DanielDW5555/mallard/README.md

# mallard
Ecological monitoring capstone for ECE 7000. The design will be a continuous redox measurement tool for peatlands.
