DanielDW5555/mallard/hardware/mallard.csv

Reference | Quantity | Value | Footprint | Datasheet | Digikey
BatteryPack1 | 1 | 3.7V | Battery:BatteryHolder_Keystone_1042_1x18650 | https://www.keyelco.com/userAssets/file/M65p27.pdf | 36-1042-ND
C1 C2 C3 C4 C5 C6 C7 C8 C9 C10 C12 C13 C14 C15 C21 | 15 | 1uF | Capacitor_SMD:C_0603_1608Metric_Pad1.08x0.95mm_HandSolder | http://weblib.samsungsem.com/mlcc/mlcc-ec-data-sheet.do?partNumber=CL10B105KO8NNN | 1276-1019-1-ND
C11 C23 | 2 | 10uF | Capacitor_SMD:C_0603_1608Metric_Pad1.08x0.95mm_HandSolder | https://www.yuden.co.jp/productdata/catalog/mlcc06_e.pdf | 587-3258-1-ND
C16 C17 C18 C19 C20 | 5 | 0.1uF | Capacitor_SMD:C_0603_1608Metric_Pad1.08x0.95mm_HandSolder |  | 445-8122-1-ND
C22 | 1 | 3.3uF | Capacitor_SMD:C_0603_1608Metric_Pad1.08x0.95mm_HandSolder | ~
D1 | 1 | D | Diode_SMD:D_SMA_Handsoldering | https://www.diodes.com/assets/Datasheets/ds16003.pdf | S1BFSCT-ND
D2 D3 D4 | 3 | LED | LED_SMD:LED_0603_1608Metric_Pad1.05x0.95mm_HandSolder | https://www.sunledusa.com/products/spec/XZVG53W-8.pdf | 1497-1215-1-ND
D5 | 1 | RED | LED_SMD:LED_0603_1608Metric_Pad1.05x0.95mm_HandSolder | ~
Eh1 Eh2 Eh3 | 3 | Eh Electrode | Connector_PinHeader_2.54mm:PinHeader_1x01_P2.54mm_Vertical | ~
J1 | 1 | USB_A | Connector_USB:USB3_A_Molex_48393-001 | https://media.digikey.com/pdf/Data%20Sheets/GCT%20PDFs/USB1130-USB1135.pdf | 2073-USB1135-15-9-L-B-ND
J2 | 1 | Conn_02x03_Odd_Even | Connector_PinHeader_1.27mm:PinHeader_2x03_P1.27mm_Vertical | https://s3.amazonaws.com/catalogspreads-pdf/PAGE94-95%20.050%20MALE%20HDR%20ST%20RA%20SMT.pdf | S9015E-03-ND
SM1 SM2 J3 SM3 | 4 | Conn_01x03 | Connector_PinHeader_2.54mm:PinHeader_1x03_P2.54mm_Vertical_SMD_Pin1Right | https://drawings-pdf.s3.amazonaws.com/11657.pdf | S1013EC-03-ND
J4 J5 J6 | 3 | Conn_01x03 | Connector_PinHeader_2.54mm:PinHeader_1x03_P2.54mm_Vertical | ~
L1 | 1 | 4.7uH | Inductor_SMD:L_0805_2012Metric_Pad1.05x1.20mm_HandSolder | ~ | 490-7782-1-ND
R1 R10x1 | 2 | 5.1k | Resistor_SMD:R_0603_1608Metric_Pad0.98x0.95mm_HandSolder | https://www.yageo.com/upload/media/product/productsearch/datasheet/rchip/PYu-RC_Group_51_RoHS_L_11.pdf | 311-5.10KHRCT-ND
R7 R11 R12 R22 | 4 | Jumper | Resistor_SMD:R_0603_1608Metric_Pad0.98x0.95mm_HandSolder | https://www.vishay.com/docs/20043/crcwhpe3.pdf | 541-0.0SBCT-ND
R14 | 1 | 1k | Resistor_SMD:R_0603_1608Metric_Pad0.98x0.95mm_HandSolder | https://www.vishay.com/docs/20065/rcse3.pdf | RHM1.00KADCT-ND
R15 | 1 | 30k | Resistor_SMD:R_0603_1608Metric_Pad0.98x0.95mm_HandSolder | https://www.yageo.com/upload/media/product/productsearch/datasheet/rchip/PYu-RT_1-to-0.01_RoHS_L_12.pdf | 311-30KDCT-ND
R16 | 1 | 20k DNI | Resistor_SMD:R_0603_1608Metric_Pad0.98x0.95mm_HandSolder | https://industrial.panasonic.com/cdbs/www-data/pdf/RDM0000/AOA0000C328.pdf | P20429CT-ND
R18 | 1 | 9.1k | Resistor_SMD:R_0603_1608Metric_Pad0.98x0.95mm_HandSolder | https://www.yageo.com/upload/media/product/productsearch/datasheet/rchip/PYu-RT_1-to-0.01_RoHS_L_12.pdf | YAG1756CT-ND
R10 R19 | 2 | 20k | Resistor_SMD:R_0603_1608Metric_Pad0.98x0.95mm_HandSolder | https://industrial.panasonic.com/cdbs/www-data/pdf/RDM0000/AOA0000C328.pdf | P20429CT-ND
R2 | 1 | 21.5k | Resistor_SMD:R_0603_1608Metric_Pad0.98x0.95mm_HandSolder | https://industrial.panasonic.com/cdbs/www-data/pdf/RDM0000/AOA0000C328.pdf | P20432CT-ND
R20 | 1 | 80.6k | Resistor_SMD:R_0603_1608Metric_Pad0.98x0.95mm_HandSolder | https://www.seielect.com/catalog/sei-rmcf_rmcp.pdf | RMCF0603FT80K6CT-ND
R21 | 1 | 324k | Resistor_SMD:R_0603_1608Metric_Pad0.98x0.95mm_HandSolder | https://industrial.panasonic.com/ww/products/pt/general-purpose-chip-resistors/models/ERJ3GEYJ362V | P3.6KGCT-ND
R23 | 1 | 680 | Resistor_SMD:R_0603_1608Metric_Pad0.98x0.95mm_HandSolder | https://www.yageo.com/upload/media/product/productsearch/datasheet/rchip/PYu-AC_51_RoHS_L_7.pdf | YAG3624CT-ND
R4 R6 R8 R13 R17 R24 | 6 | 10k | Resistor_SMD:R_0603_1608Metric_Pad0.98x0.95mm_HandSolder | https://www.yageo.com/upload/media/product/productsearch/datasheet/rchip/PYu-RC_Group_51_RoHS_L_11.pdf | 13-RC0603DR-0710KLCT-ND
R25 | 1 | 370 | Resistor_SMD:R_0603_1608Metric_Pad0.98x0.95mm_HandSolder | ~
R3 R5 | 2 | 3.6k | Resistor_SMD:R_0603_1608Metric_Pad0.98x0.95mm_HandSolder | https://industrial.panasonic.com/ww/products/pt/general-purpose-chip-resistors/models/ERJ3GEYJ362V | P3.6KGCT-ND
R9 | 1 | Jumper DNI | Resistor_SMD:R_0603_1608Metric_Pad0.98x0.95mm_HandSolder | https://www.vishay.com/docs/20043/crcwhpe3.pdf | 541-0.0SBCT-ND
Ref1 | 1 | Conn_01x02 | Connector_Coaxial:BNC_TEConnectivity_1478204_Vertical | https://www.te.com/commerce/DocumentDelivery/DDEController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 | A97581-ND
Ref2 | 1 | Conn_01x02 | mallard:mallardScrewTerm.
SW1 | 1 | RESET Switch | Button_Switch_SMD:SW_SPST_B3U-1000P | https://omronfs.omron.com/en_US/ecb/products/pdf/en-b3u.pdf | SW1020CT-ND
TH1 | 1 | 103AT | Resistor_THT:R_Axial_DIN0204_L3.6mm_D1.6mm_P2.54mm_Vertical | ~
U1 U2 U3 | 3 | TMP235 |  | https://www.ti.com/lit/ds/symlink/tmp235-q1.pdf?HQS=dis-dk-null-digikeymode-dsf-pf-null-wwe&ts=1643211475158 | 296-TMP235AEDBZTQ1CT-ND
U10 | 1 | LM828 | Package_TO_SOT_SMD:SOT-23-5 | https://www.ti.com/lit/ds/symlink/lm828.pdf?HQS=dis-dk-null-digikeymode-dsf-pf-null-wwe&ts=1643222784613 | 296-36289-1-ND
U11 | 1 | STM32L4Q5xx | Package_QFP:LQFP-48_7x7mm_P0.5mm | https://www.st.com/resource/en/datasheet/stm32l4q5ag.pdf | 497-STM32L4Q5CGT6-ND
U12 | 1 | LTC3529EDCB | mallard:DFN200X300X80-9N | https://www.analog.com/media/en/technical-documentation/data-sheets/3529fb.pdf | 161-LTC3529EDCB#TRPBFCT-ND
U4 | 1 | BQ24210DQCT | Package_SON:WSON-10-1EP_2x3mm_P0.5mm_EP0.84x2.4mm | https://www.ti.com/lit/ds/symlink/bq24210.pdf?HQS=dis-dk-null-digikeymode-dsf-pf-null-wwe&ts=1627409280722 | 296-28738-1-ND
U5 U6 | 2 | TMUX1309 | Package_DFN_QFN:WQFN-16-1EP_3x3mm_P0.5mm_EP1.6x1.6mm | https://www.ti.com/lit/ds/symlink/tmux1309.pdf | 296-TMUX1309BQBRCT-ND
U7 | 1 | LMP7721 | Package_SO:SOIC-8_3.9x4.9mm_P1.27mm | https://www.ti.com/general/docs/suppproductinfo.tsp?distId=10 | LMP7721MA/NOPB-ND
U8 | 1 | TPS71710DRVR | Package_SON:WSON-6-1EP_2x2mm_P0.65mm_EP1x1.6mm | https://www.ti.com/lit/ds/symlink/tps717.pdf?HQS=dis-dk-null-digikeymode-dsf-pf-null-wwe&ts=1633366861578 | 296-22984-1-ND
U9 | 1 | LMV554 | Package_SO:TSSOP-14_4.4x5mm_P0.65mm | https://www.ti.com/lit/ds/symlink/lmv551.pdf?HQS=dis-dk-null-digikeymode-dsf-pf-null-wwe&ts=1626469395066 | 296-51370-1-ND
