DanielDW5555/mallard/hardware/mallard.kicad_pcb

## KiCad design hardware/mallard.kicad_pcb (2022-01-26)

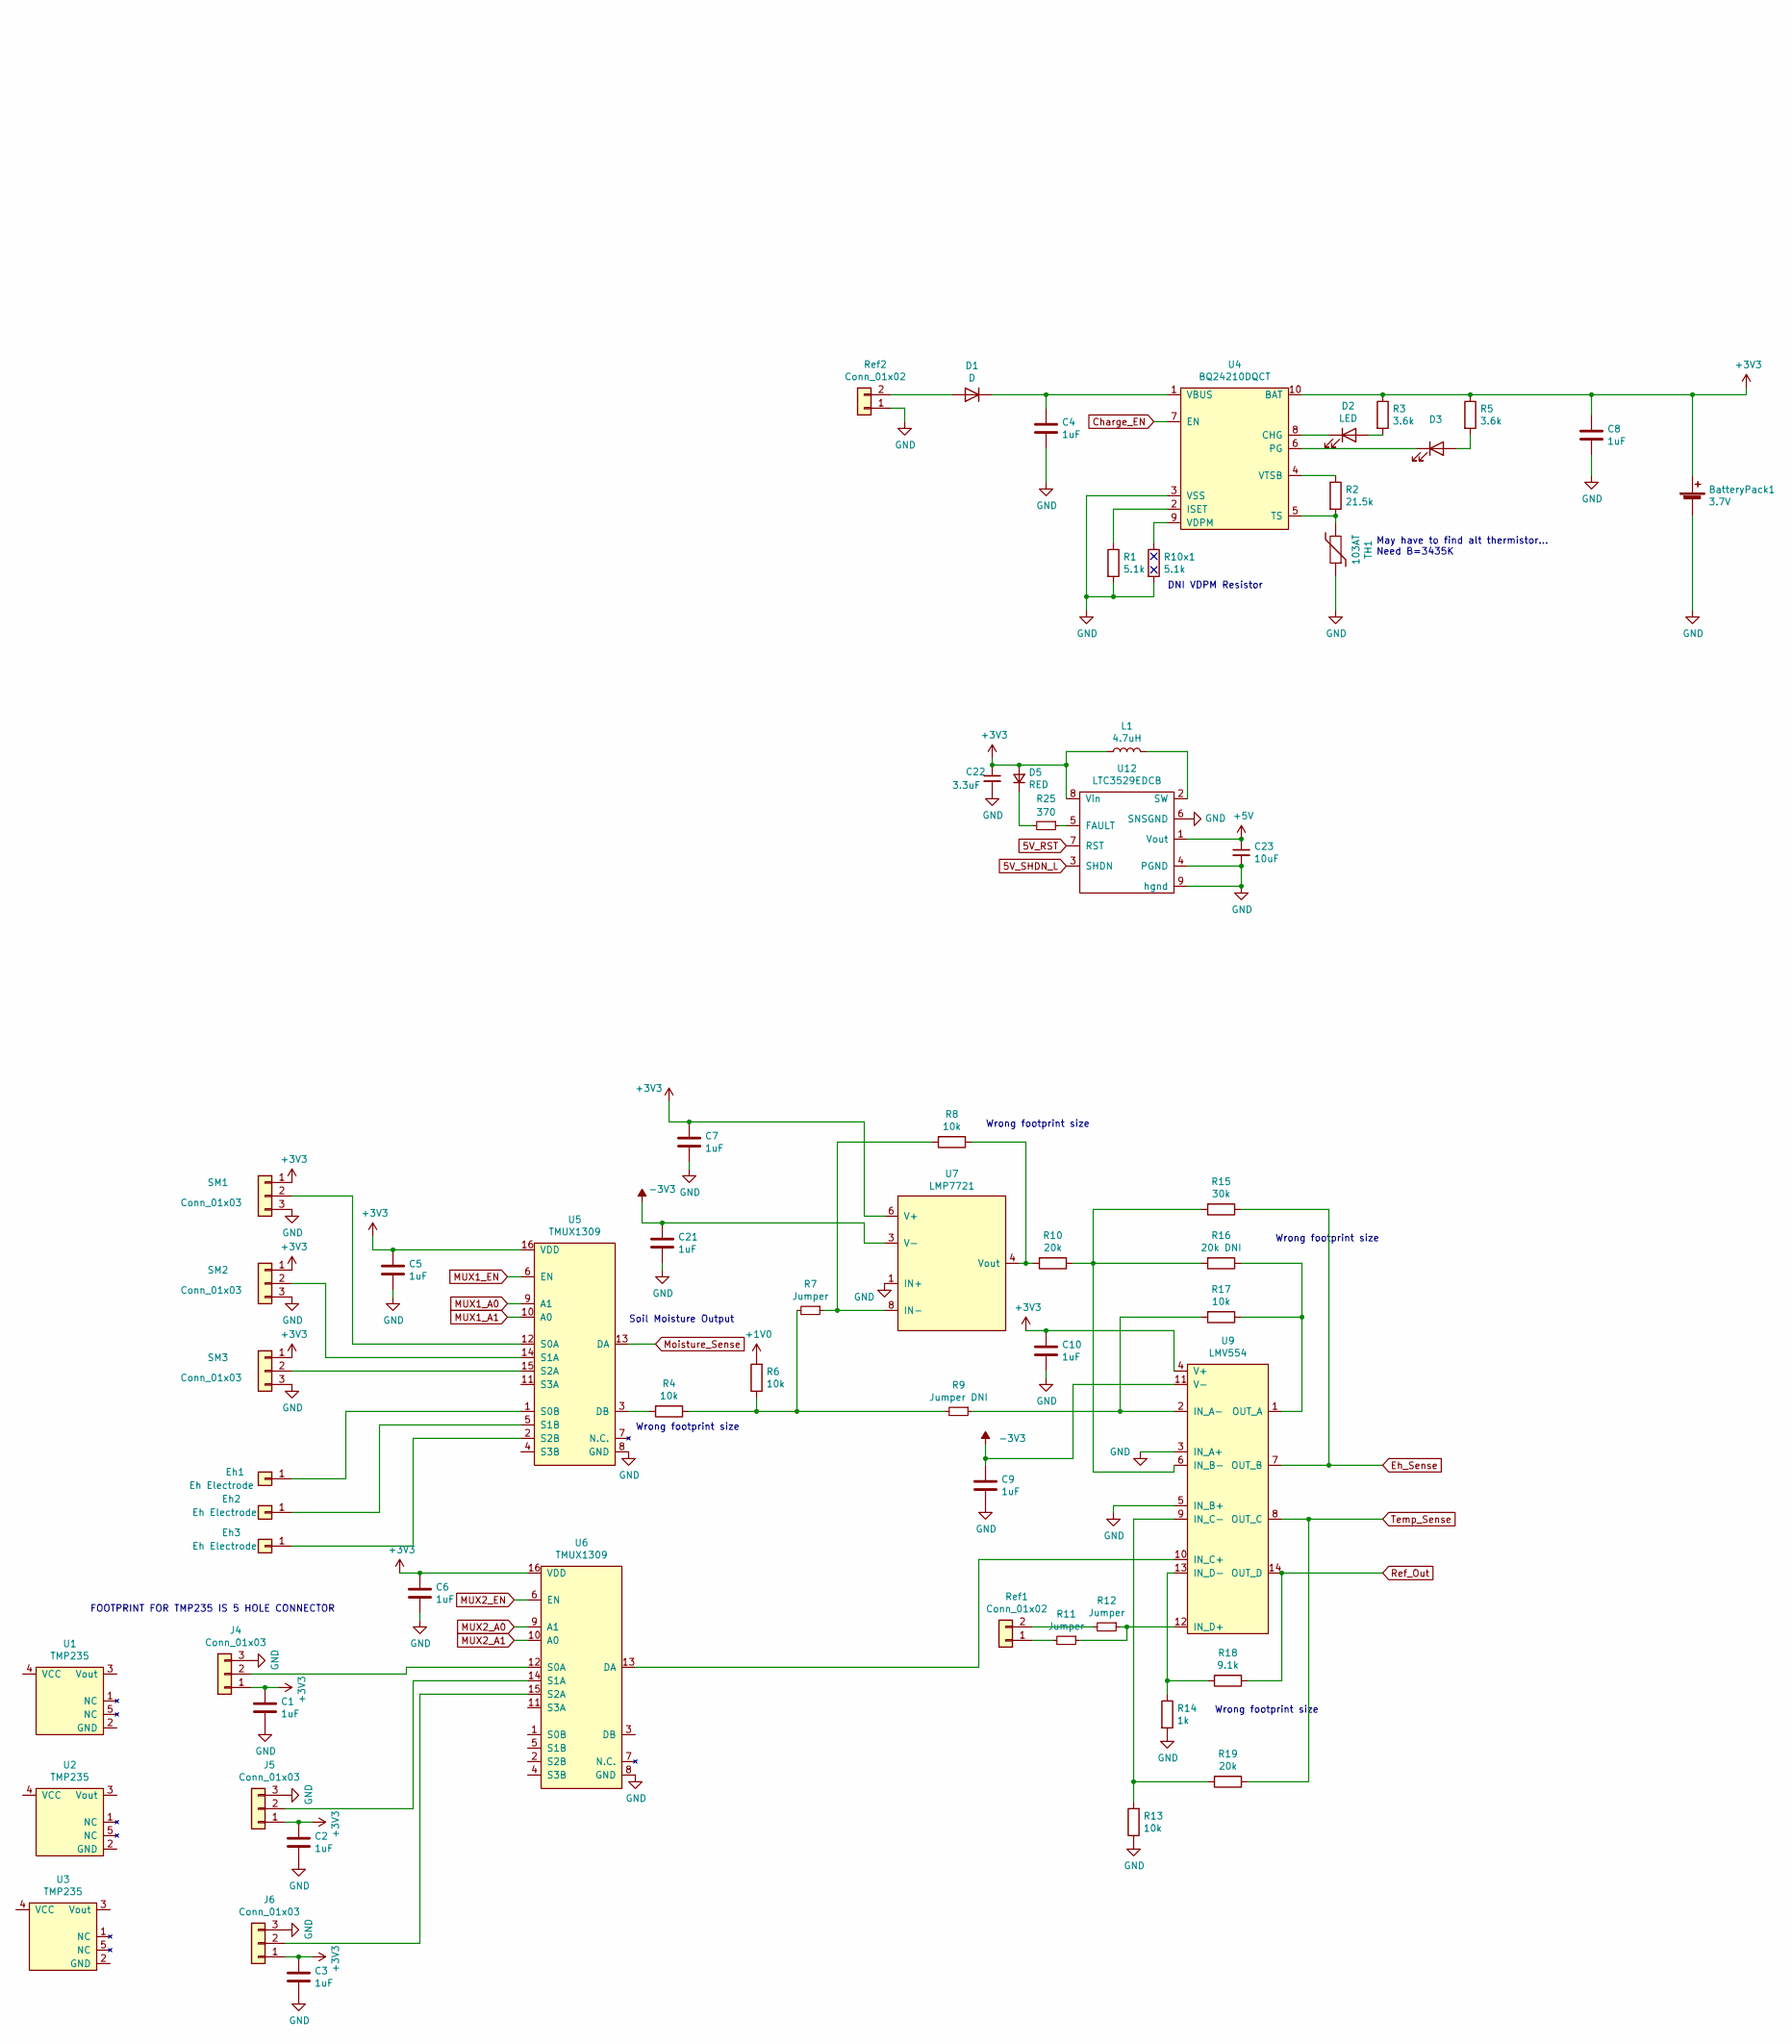
[picture p1: schematic mallard.sch, part in row 1, column 1]

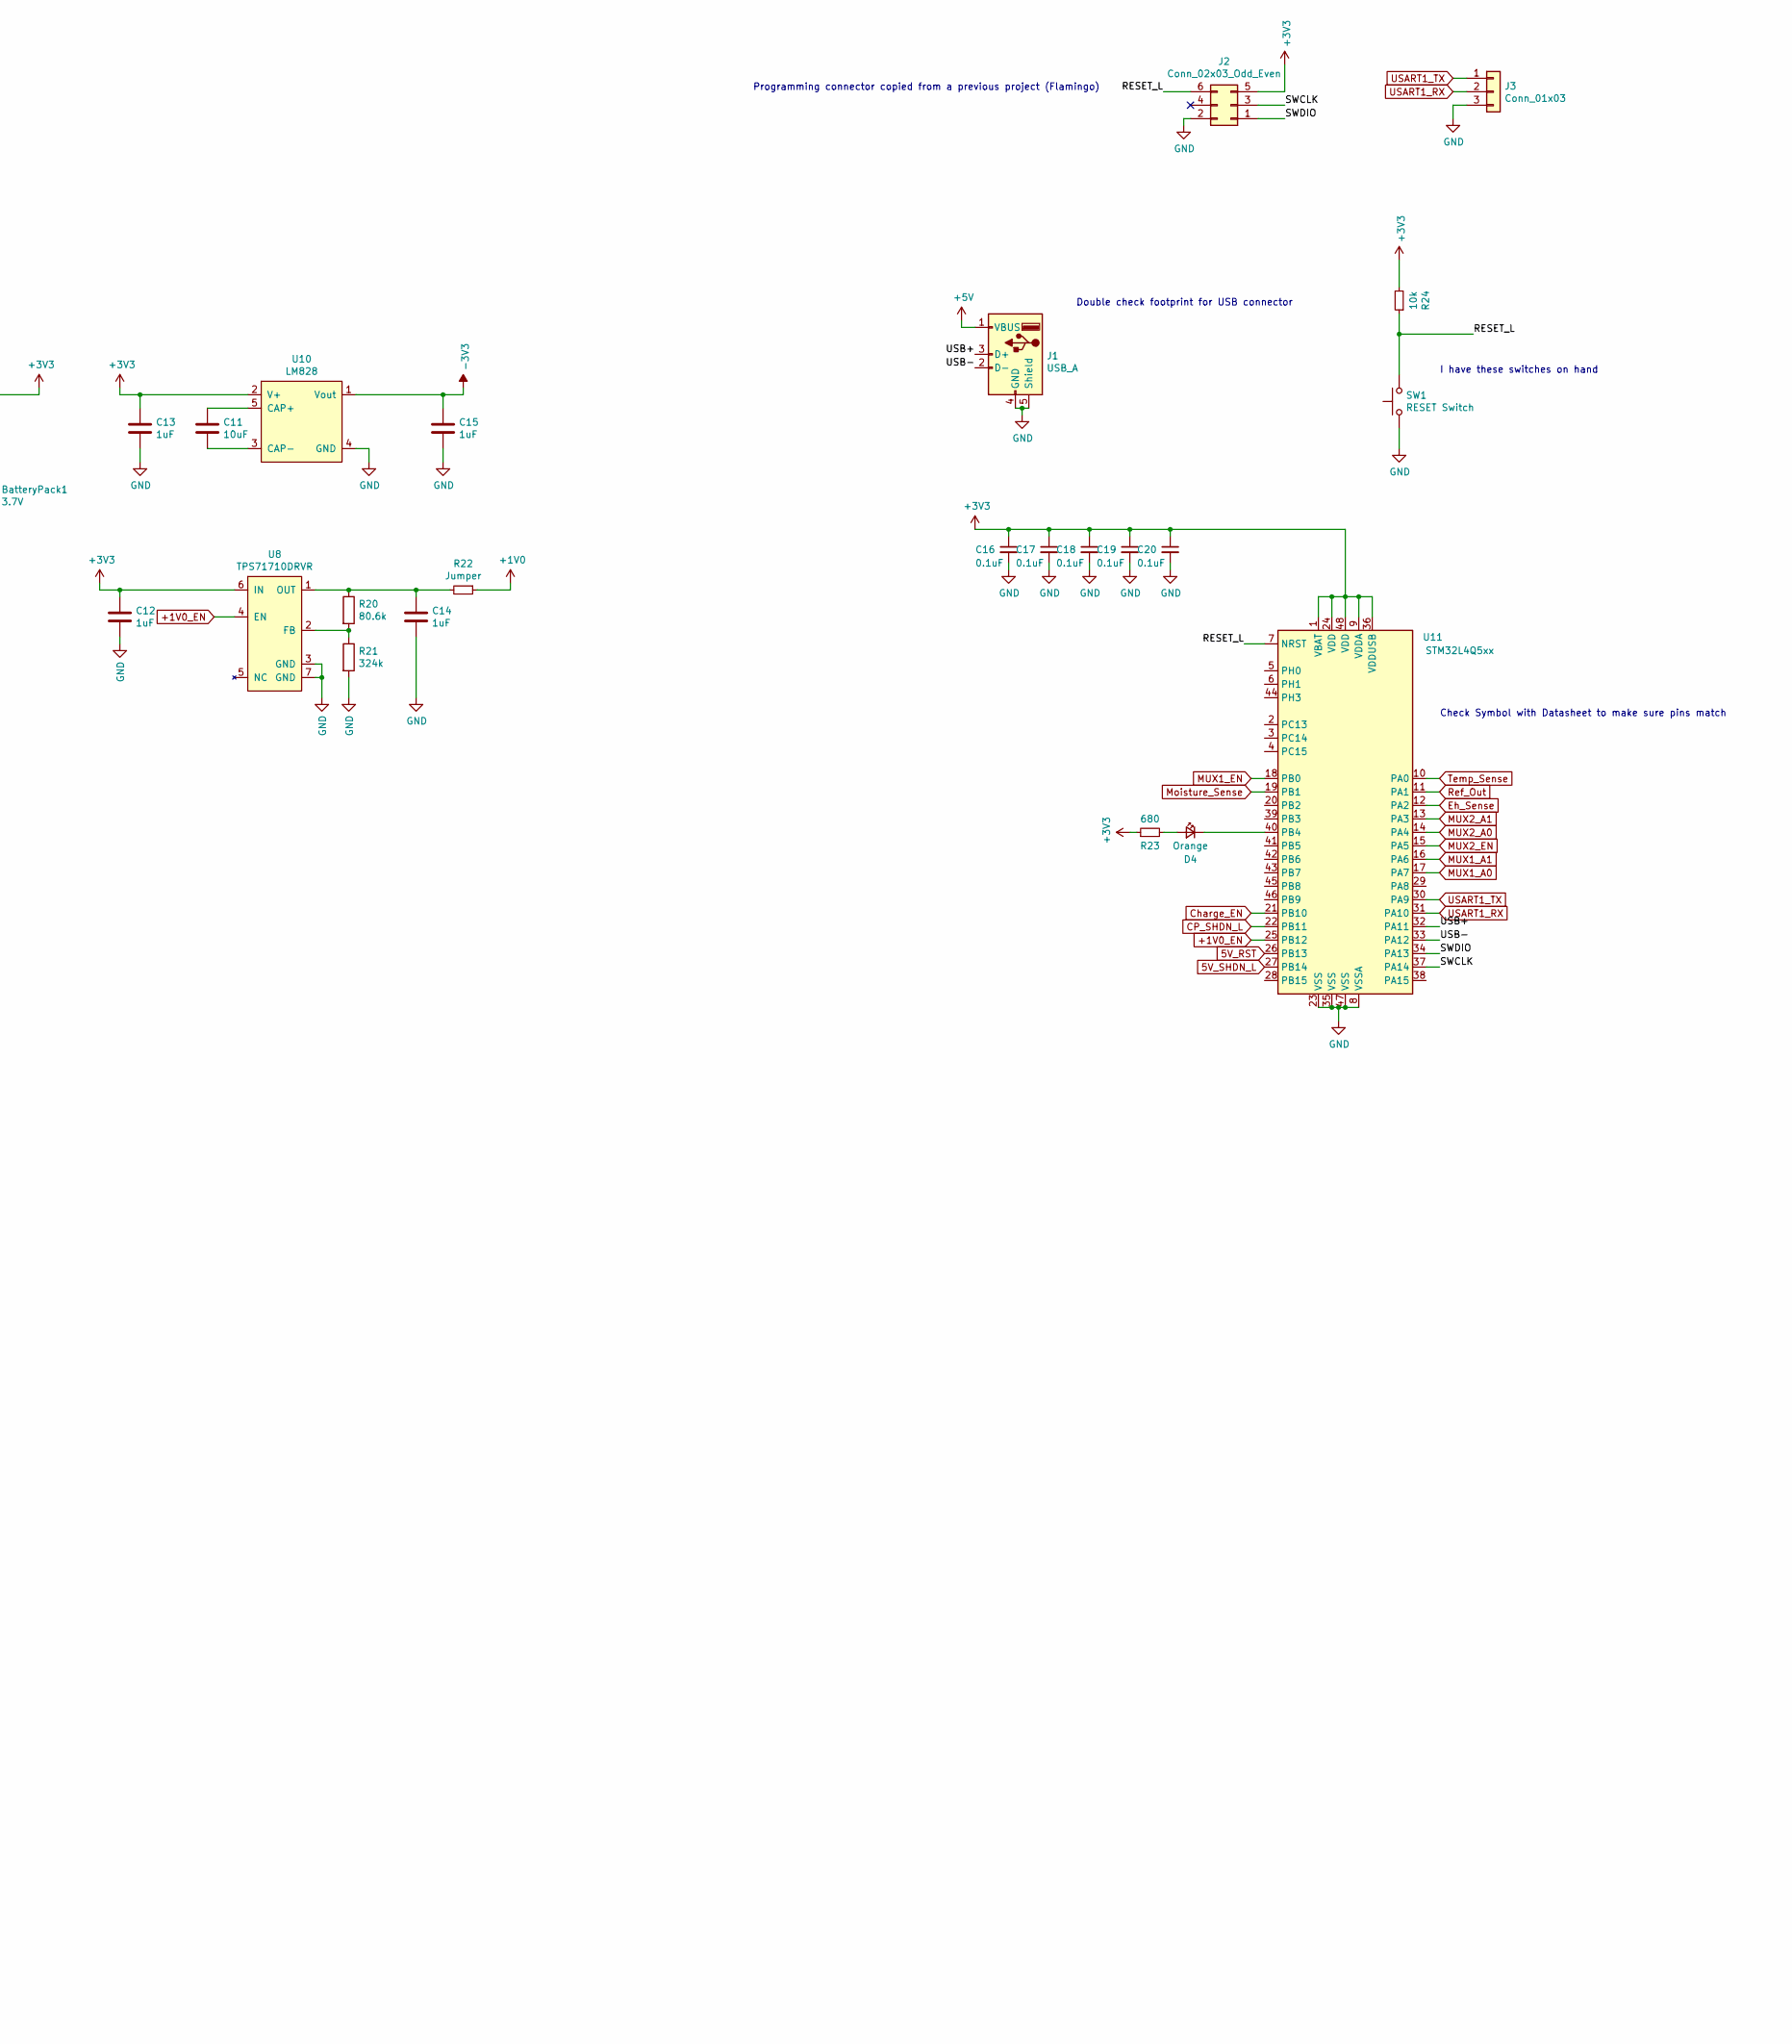
[picture p2: schematic mallard.sch, part in row 1, column 2]

Parts:
BatteryPack1: 3.7V; BatteryHolder_Keystone_1042_1x18650; Digikey 36-1042-ND
C1, C2, C3, C4, C5, C6, C7, C8, C9, C10, C12, C13, C14, C15, C21: 1uF; C_0603_1608Metric_Pad1.08x0.95mm_HandSolder; Digikey 311-1446-1-ND
C11: 10uF; C_0603_1608Metric_Pad1.08x0.95mm_HandSolder; Digikey 587-3258-1-ND
C16, C17, C18, C19, C20: 0.1uF; C_0603_1608Metric_Pad1.08x0.95mm_HandSolder; Digikey 445-8122-1-ND
C22: 3.3uF; C_0603_1608Metric_Pad1.08x0.95mm_HandSolder
C23: 10uF; C_0603_1608Metric_Pad1.08x0.95mm_HandSolder
D1: D; D_SMA_Handsoldering; Digikey S1B-FDICT-ND
D2, D3: LED; LED_0603_1608Metric_Pad1.05x0.95mm_HandSolder; Digikey 1497-1215-1-ND
D4: Orange; D_0805_2012Metric_Castellated; Digikey 160-1413-1-ND
D5: RED; LED_0603_1608Metric_Pad1.05x0.95mm_HandSolder
Eh1, Eh2, Eh3: Eh Electrode; PinHeader_1x01_P2.54mm_Vertical
J1: USB_A; USB3_A_Molex_48393-001; Digikey 2073-USB1135-15-9-L-B-ND
J2: Conn_02x03_Odd_Even; PinHeader_2x03_P1.27mm_Vertical; Digikey S9015E-03-ND
J3: Conn_01x03; PinHeader_1x03_P2.54mm_Vertical_SMD_Pin1Right; Digikey S1013EC-03-ND
J4, J5, J6: Conn_01x03; PinHeader_1x03_P2.54mm_Vertical
L1: 4.7uH; L_0805_2012Metric_Pad1.05x1.20mm_HandSolder; Digikey 490-7782-1-ND
R1, R10x1: 5.1k; R_0603_1608Metric_Pad0.98x0.95mm_HandSolder; Digikey 311-5.10KHRCT-ND
R2: 21.5k; R_0603_1608Metric_Pad0.98x0.95mm_HandSolder; Digikey P20432CT-ND
R3, R5: 3.6k; R_0603_1608Metric_Pad0.98x0.95mm_HandSolder; Digikey P3.6KGCT-ND
R4, R6, R8, R13, R17, R24: 10k; R_0603_1608Metric_Pad0.98x0.95mm_HandSolder; Digikey 13-RC0603DR-0710KLCT-ND
R7, R11, R12, R22: Jumper; R_0603_1608Metric_Pad0.98x0.95mm_HandSolder; Digikey 541-0.0SBCT-ND
R9: Jumper DNI; R_0603_1608Metric_Pad0.98x0.95mm_HandSolder; Digikey 541-0.0SBCT-ND
R10, R19: 20k; R_0603_1608Metric_Pad0.98x0.95mm_HandSolder; Digikey P20429CT-ND
R14: 1k; R_0603_1608Metric_Pad0.98x0.95mm_HandSolder; Digikey 541-2788-1-ND
R15: 30k; R_0603_1608Metric_Pad0.98x0.95mm_HandSolder; Digikey 311-30KDCT-ND
R16: 20k DNI; R_0603_1608Metric_Pad0.98x0.95mm_HandSolder; Digikey P20429CT-ND
R18: 9.1k; R_0603_1608Metric_Pad0.98x0.95mm_HandSolder; Digikey YAG1756CT-ND
R20: 80.6k; R_0603_1608Metric_Pad0.98x0.95mm_HandSolder; Digikey RMCF0603FT80K6CT-ND
R21: 324k; R_0603_1608Metric_Pad0.98x0.95mm_HandSolder; Digikey P3.6KGCT-ND
R23: 680; R_0603_1608Metric_Pad0.98x0.95mm_HandSolder; Digikey YAG3624CT-ND
R25: 370; R_0603_1608Metric_Pad0.98x0.95mm_HandSolder
Ref1: Conn_01x02; BNC_TEConnectivity_1478204_Vertical; Digikey A97581-ND
Ref2: Conn_01x02; mallardScrewTerm.
SM1, SM2, SM3: Conn_01x03; PinHeader_1x03_P2.54mm_Vertical_SMD_Pin1Right; Digikey S1013EC-03-ND
SW1: RESET Switch; SW_SPST_B3U-1000P; Digikey SW1020CT-ND
TH1: 103AT; R_Axial_DIN0204_L3.6mm_D1.6mm_P2.54mm_Vertical
U1, U2, U3: TMP235; Digikey 296-48860-1-ND
U4: BQ24210DQCT; WSON-10-1EP_2x3mm_P0.5mm_EP0.84x2.4mm; Digikey 296-28738-1-ND
U5, U6: TMUX1309; WQFN-16-1EP_3x3mm_P0.5mm_EP1.6x1.6mm; Digikey 296-TMUX1309BQBRCT-ND
U7: LMP7721; SOIC-8_3.9x4.9mm_P1.27mm; Digikey LMP7721MA/NOPB-ND
U8: TPS71710DRVR; WSON-6-1EP_2x2mm_P0.65mm_EP1x1.6mm; Digikey 296-22984-1-ND
U9: LMV554; TSSOP-14_4.4x5mm_P0.65mm; Digikey 296-51370-1-ND
U10: LM828; SOT-23-5; Digikey 296-36289-1-ND
U11: STM32L4Q5xx; LQFP-48_7x7mm_P0.5mm; Digikey 497-STM32L4Q5CGT6-ND
U12: LTC3529EDCB; DFN200X300X80-9N; Digikey 161-LTC3529EDCB#TRPBFCT-ND

Connections:
5V_RST: U11.26 (PB13), U12.7 (RST)
5V_SHDN_L: U11.27 (PB14), U12.3 (SHDN)
+1V0: R6.2, R22.1
+1V0_EN: U8.4 (EN), U11.25 (PB12)
+3V3: BatteryPack1.1 (+), C1.1, C2.1, C3.1, C5.1, C6.1, C7.1, C8.1, C10.1, C12.1, C13.1, C16.1, C17.1, C18.1, C19.1, C20.1, C22.1, D5.2 (A), J2.5, J4.1, J5.1, J6.1, L1.1, R3.1, R5.1, R23.1, R24.2, SM1.1, SM2.1, SM3.1, U4.10 (BAT), U5.16 (VDD), U6.16 (VDD), U7.6 (V+), U8.6 (IN), U9.4 (V+), U10.2 (V+), U11.1 (VBAT), U11.9 (VDDA), U11.24 (VDD), U11.36 (VDDUSB), U11.48 (VDD), U12.8 (Vin)
+5V: C23.1, J1.1 (VBUS), U12.1 (Vout)
-3V3: C9.1, C15.1, C21.1, U7.3 (V-), U9.11 (V-), U10.1 (Vout)
/RESET_L: J2.6, R24.1, SW1.2, U11.7 (NRST)
/SWCLK: J2.3, U11.37 (PA14)
/SWDIO: J2.1, U11.34 (PA13)
/USB+: J1.3 (D+), U11.32 (PA11)
/USB-: J1.2 (D-), U11.33 (PA12)
CP_SHDN_L: U11.22 (PB11)
Charge_EN: U4.7 (EN), U11.21 (PB10)
Eh_Sense: R15.1, U9.7 (OUT_B), U11.12 (PA2)
GND: BatteryPack1.2 (-), C1.2, C2.2, C3.2, C4.2, C5.2, C6.2, C7.2, C8.2, C9.2, C10.2, C12.2, C13.2, C14.2, C15.2, C16.2, C17.2, C18.2, C19.2, C20.2, C21.2, C22.2, C23.2, J1.4 (GND), J1.5 (Shield), J2.2, J3.3, J4.3, J5.3, J6.3, R1.2, R10x1.2, R13.1, R14.2, R21.2, Ref2.1, SM1.3, SM2.3, SM3.3, SW1.1, TH1.1, U4.3 (VSS), U5.8 (GND), U6.8 (GND), U7.1 (IN+), U8.3 (GND), U8.7 (GND), U9.3 (IN_A+), U9.5 (IN_B+), U10.4 (GND), U11.8 (VSSA), U11.23 (VSS), U11.35 (VSS), U11.47 (VSS), U12.4 (PGND), U12.6 (SNSGND), U12.9 (hgnd)
MUX1_A0: U5.9 (A1), U11.17 (PA7)
MUX1_A1: U5.10 (A0), U11.16 (PA6)
MUX1_EN: U5.6 (EN), U11.18 (PB0)
MUX2_A0: U6.9 (A1), U11.14 (PA4)
MUX2_A1: U6.10 (A0), U11.13 (PA3)
MUX2_EN: U6.6 (EN), U11.15 (PA5)
Moisture_Sense: U5.13 (DA), U11.19 (PB1)
unnamed: C4.1, D1.1 (K), U4.1 (VBUS)
unnamed: C11.1, U10.5 (CAP+)
unnamed: C11.2, U10.3 (CAP-)
unnamed: C14.1, R20.1, R22.2, U8.1 (OUT)
unnamed: D1.2 (A), Ref2.2
unnamed: D2.1 (K), U4.8 (CHG)
unnamed: D2.2 (A), R3.2
unnamed: D3.1 (K), U4.6 (PG)
unnamed: D3.2 (A), R5.2
unnamed: D4.1 (K), U11.40 (PB4)
unnamed: D4.2 (A), R23.2
unnamed: D5.1 (K), R25.2
unnamed: Eh1.1, U5.1 (S0B)
unnamed: Eh2.1, U5.5 (S1B)
unnamed: Eh3.1, U5.2 (S2B)
unnamed: J4.2, U6.12 (S0A)
unnamed: J5.2, U6.14 (S1A)
unnamed: J6.2, U6.15 (S2A)
unnamed: L1.2, U12.2 (SW)
unnamed: R1.1, U4.2 (ISET)
unnamed: R2.1, U4.4 (VTSB)
unnamed: R2.2, TH1.2, U4.5 (TS)
unnamed: R4.1, R6.1, R7.2, R9.2
unnamed: R4.2, U5.3 (DB)
unnamed: R7.1, R8.2, U7.8 (IN-)
unnamed: R10.1, R15.2, R16.2, U9.6 (IN_B-)
unnamed: R8.1, R10.2, U7.4 (Vout)
unnamed: R10x1.1, U4.9 (VDPM)
unnamed: R11.1, R12.1, U9.12 (IN_D+)
unnamed: R11.2, Ref1.1
unnamed: R12.2, Ref1.2
unnamed: R13.2, R19.2, U9.9 (IN_C-)
unnamed: R14.1, R18.2, U9.13 (IN_D-)
unnamed: R16.1, R17.1, U9.1 (OUT_A)
unnamed: R9.1, R17.2, U9.2 (IN_A-)
unnamed: R20.2, R21.1, U8.2 (FB)
unnamed: R25.1, U12.5 (FAULT)
unnamed: SM1.2, U5.12 (S0A)
unnamed: SM2.2, U5.14 (S1A)
unnamed: SM3.2, U5.15 (S2A)
unnamed: U6.13 (DA), U9.10 (IN_C+)
Ref_Out: R18.1, U9.14 (OUT_D), U11.11 (PA1)
Temp_Sense: R19.1, U9.8 (OUT_C), U11.10 (PA0)
USART1_RX: J3.2, U11.31 (PA10)
USART1_TX: J3.1, U11.30 (PA9)

Notes on the sheet:
Check Symbol with Datasheet to make sure pins match
Double check footprint for USB connector
I have these switches on hand
FOOTPRINT FOR TMP235 IS 5 HOLE CONNECTOR
DNI VDPM Resistor
May have to find alt thermistor... Need B=3435K
Programming connector copied from a previous project (Flamingo)
Wrong footprint size
Soil Moisture Output

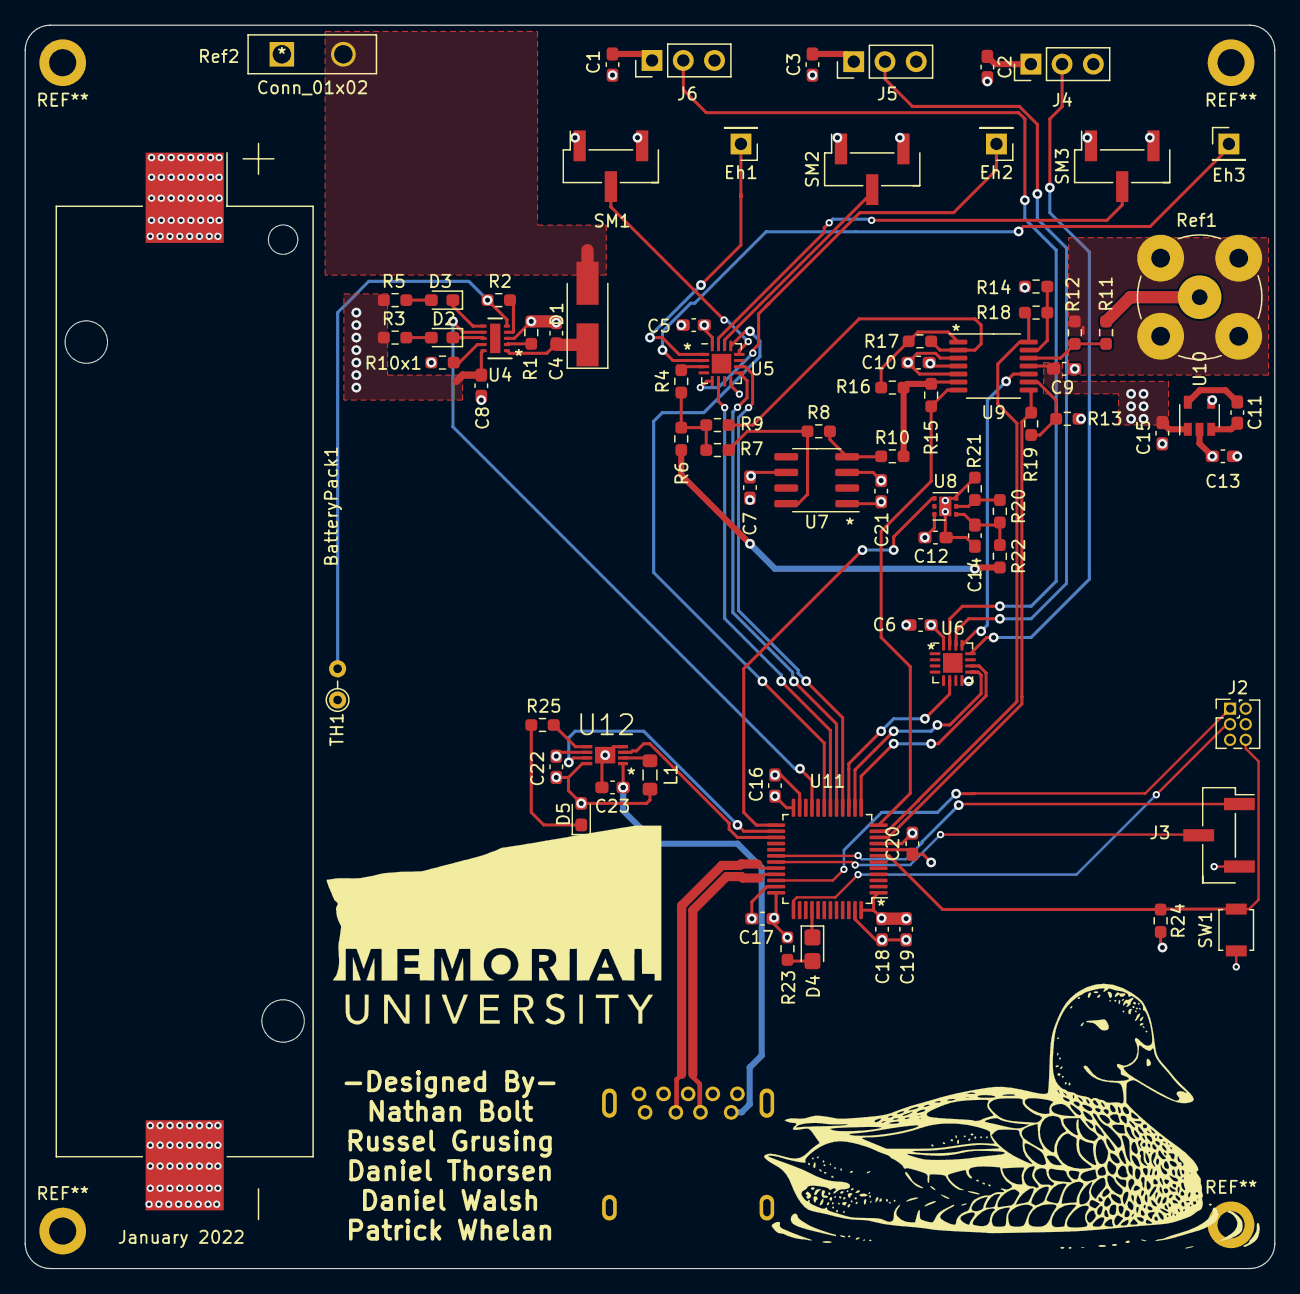
[picture p3: board mallard.kicad_pcb from above]

Board: 4 copper layers, 101.6 x 101.1 mm, 81 parts (1 on the bottom side), 67 nets.
