DanielDW5555/mallard/firmware/mallard/Core/Src/main.c

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
/* Includes ------------------------------------------------------------------*/
#include "main.h"
#include "fatfs.h"
#include "usb_host.h"

/* USER CODE BEGIN Includes */
#include <stdio.h>
/* USER CODE END Includes */

ADC_HandleTypeDef hadc1;

UART_HandleTypeDef huart1;

void SystemClock_Config(void);
void PeriphCommonClock_Config(void);
static void MX_GPIO_Init(void);
static void MX_ADC1_Init(void);
static void MX_USART1_UART_Init(void);
void MX_USB_HOST_Process(void);

/* USER CODE BEGIN 0 */
// ************************************************* START FUNCTIONS HERE ***************************************

// Blinky!!
void blinky(void)
{
	for(int i = 0; i < 2; i ++)
	{
		HAL_GPIO_TogglePin(GPIOB, GPIO_PIN_4);
		HAL_Delay(500);
		HAL_GPIO_TogglePin(GPIOB, GPIO_PIN_4);
		HAL_Delay(500);
	}
}

// ADC Channel Select EH
void ADC_Select_EH(void)
{
	ADC_ChannelConfTypeDef sConfig = {0};

	sConfig.Channel = ADC_CHANNEL_7;
	sConfig.Rank = 1;
	sConfig.SamplingTime = ADC_SAMPLETIME_2CYCLES_5;
	sConfig.SingleDiff = ADC_SINGLE_ENDED;
	sConfig.OffsetNumber = ADC_OFFSET_NONE;
	sConfig.Offset = 0;
	if (HAL_ADC_ConfigChannel(&hadc1, &sConfig) != HAL_OK)
	{
	Error_Handler();
	}
}

// ADC Channel Select REF
void ADC_Select_REF(void)
{
	ADC_ChannelConfTypeDef sConfig = {0};

	sConfig.Channel = ADC_CHANNEL_6;
	sConfig.Rank = 1;
	sConfig.SamplingTime = ADC_SAMPLETIME_2CYCLES_5;
	sConfig.SingleDiff = ADC_SINGLE_ENDED;
	sConfig.OffsetNumber = ADC_OFFSET_NONE;
	sConfig.Offset = 0;
	if (HAL_ADC_ConfigChannel(&hadc1, &sConfig) != HAL_OK)
	{
	Error_Handler();
	}
}

// ADC Channel Select TEMP
void ADC_Select_TEMP(void)
{
	ADC_ChannelConfTypeDef sConfig = {0};

	sConfig.Channel = ADC_CHANNEL_5;
	sConfig.Rank = 1;
	sConfig.SamplingTime = ADC_SAMPLETIME_2CYCLES_5;
	sConfig.SingleDiff = ADC_SINGLE_ENDED;
	sConfig.OffsetNumber = ADC_OFFSET_NONE;
	sConfig.Offset = 0;
	if (HAL_ADC_ConfigChannel(&hadc1, &sConfig) != HAL_OK)
	{
	Error_Handler();
	}
}

// UART Write
void _write(int file, char *ptr, int len)
{
	HAL_UART_Transmit(&huart1, (uint8_t*)ptr, len, HAL_MAX_DELAY);
}

/* USER CODE END 0 */

/**
  * @brief  The application entry point.
  * @retval int
  */
int main(void)
{
  /* MCU Configuration--------------------------------------------------------*/

  /* Reset of all peripherals, Initializes the Flash interface and the Systick. */
  HAL_Init();

  /* Configure the system clock */
  SystemClock_Config();

/* Configure the peripherals common clocks */
  PeriphCommonClock_Config();

  /* Initialize all configured peripherals */
  MX_GPIO_Init();
  MX_ADC1_Init();
  MX_USART1_UART_Init();
  MX_USB_HOST_Init();
  MX_FATFS_Init();
  /* USER CODE BEGIN 2 */

  // ************************************************* START BEFORE WHILE CODE HERE ***************************************

  // Bootup Blinkys
  // These are put in place to allow programming before the microcontroller enters its sleep loop, currently its set to wait 5 seconds before entering sleep mode

  printf("System Starting!\r\n");

  blinky();
  // HAL_Delay(5000);
  //Assign ADC Variable
  uint16_t ADC_READING = 0;

  // Enable 1V0 Regulator
  // HAL_GPIO_WritePin(GPIOB, GPIO_PIN_12, GPIO_PIN_SET);

  // Enable 5V0 Regulator
  HAL_GPIO_WritePin(GPIOB, GPIO_PIN_14, GPIO_PIN_SET);


  // ************************************************* END BEFORE WHILE CODE HERE ***************************************



  /* USER CODE END 2 */

  /* Infinite loop */
  /* USER CODE BEGIN WHILE */
  while (1)
  {
    /* USER CODE END WHILE */
    MX_USB_HOST_Process();

    /* USER CODE BEGIN 3 */


    // ************************************************* START WHILE CODE HERE ***************************************

    // TODO: Add conversion equations to convert ADC value to voltage

    // READ EH
    // Switch ADC channel to EH
    ADC_Select_EH();
    //Start ADC Conversion
	HAL_ADC_Start(&hadc1);
	// Pole to see if converstion is finished
	HAL_ADC_PollForConversion(&hadc1, HAL_MAX_DELAY);
    // Store ADC Value in ADC_Reading
    ADC_READING = HAL_ADC_GetValue(&hadc1);
    HAL_ADC_Stop(&hadc1);

    // Print ADC value through UART
	printf("EH: %d\r\n", ADC_READING);

	// READ REF
	// Switch ADC channel to REF
	ADC_Select_REF();
	//Start ADC Conversion
	HAL_ADC_Start(&hadc1);
	// Pole to see if converstion is finished
	HAL_ADC_PollForConversion(&hadc1, HAL_MAX_DELAY);
	// Store ADC Value in ADC_Reading
	ADC_READING = HAL_ADC_GetValue(&hadc1);
	HAL_ADC_Stop(&hadc1);

	// Print ADC value through UART
	printf("REF: %d\r\n", ADC_READING);

	// READ TEMP
	// Switch ADC channel to TEMP
	ADC_Select_TEMP();
	//Start ADC Conversion
	HAL_ADC_Start(&hadc1);
	// Pole to see if converstion is finished
	HAL_ADC_PollForConversion(&hadc1, HAL_MAX_DELAY);
	// Store ADC Value in ADC_Reading
	ADC_READING = HAL_ADC_GetValue(&hadc1);
	HAL_ADC_Stop(&hadc1);

	// Print ADC value through UART
	printf("TEMP: %d\r\n", ADC_READING);



    // Enter sleep mode using RTC wakeup functions
    // enterSleepMode(3); // Parameter depicts how long the sleep cycle is (currently its set to 3 seconds)
    blinky();

  }
  // ************************************************* END WHILE CODE HERE ***************************************




  /* USER CODE END 3 */
}

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
