DanielDW5555/mallard/firmware/mallard/mallard.ioc

Mcu.UserName=STM32L4Q5CGTx
PA0.Signal=ADCx_IN5
PA1.GPIO_Label=Temp Sense 1
PA1.Signal=ADCx_IN6
PA10.Signal=USART1_RX
PA11.Signal=USB_OTG_FS_DM
PA12.Signal=USB_OTG_FS_DP
PA2.GPIO_Label=Eh Sense 1
PA2.Signal=ADCx_IN7
PA3.GPIO_Label=Temp Sense 2
PA3.Signal=ADCx_IN8
PA4.Signal=ADCx_IN9
PA5.GPIO_Label=Temp Sense 3
PA5.Signal=ADCx_IN10
PA6.Signal=ADCx_IN11
PA7.Signal=GPIO_Output
PA8.Signal=RCC_MCO
PA9.Signal=USART1_TX
PB0.Signal=GPIO_Output
PB1.Signal=ADCx_IN16
PB10.GPIO_Label=Charge Enable
PB10.Signal=GPIO_Output
PB12.GPIO_Label=Enable 1V
PB12.Signal=GPIO_Output
PB13.GPIO_Label=Reset 5V
PB13.Signal=GPIO_Output
PB14.GPIO_Label=_5V_SHDN
PB14.Signal=GPIO_Output
PC13.Signal=GPIO_Output
