DanielDW5555/mallard/(commit log)

2021-05-30 Created kicad project
    [instrumentation.sch, mallard.kicad_pcb, mallard.sch, microcontroiller.sch, power.sch]
2021-07-02 Added resistors
    Added resistors to top level elements
    [mallard.sch, microcontroiller.sch, power.sch]
2021-07-03 Removed Resistors
    [mallard.sch]
2021-07-16 Added Internal Wakeup RTC Functions
    Currently commented out because it makes programming the STM much more difficult.
2021-07-16 Added Instrumentation Components To Kicad
    Added SN74HCS153, LMV554, and TMP235.
    [instrumentation.sch, mallard.sch, microcontroiller.sch, power.sch]
2021-07-27 Started working on demo firmware
    [mallard Debug.cfg]
2021-07-27 Added symbols for BQ24210DQCT and LTC1983ES6-3
    [power.sch]
2021-07-28 Create power.pro
    created a schematic for the power system
    [power.sch]
2021-08-03 Added TMUX1309 symbol
    [instrumentation.sch, power.sch]
2021-08-05 Added Instrumentation Circuits
    [instrumentation.sch]
2021-08-05 added blocking diode
    [power.sch]
2021-10-01 Added all Digikey part numbers. Started MC schematic. Fixed the reference number on some symbols.
    [instrumentation.sch, microcontroiller.sch, power.sch]
2021-10-04 Finished MC design
    [instrumentation.sch, microcontroiller.sch, power.sch]
2021-10-04 Added 1V LDO. Added LDO symbol
    [microcontroiller.sch, power.sch]
2021-11-08 Not sure what changes I made sry
    [instrumentation.sch, microcontroiller.sch, power.sch]
2021-11-10 House Keeping Tasks
    - Modified parts list parameters for various parts
    - Assigned Ref Des to components
    - Changed TPS717 symbol and feedback resistors
    [instrumentation.sch, microcontroiller.sch, power.sch]
2021-11-11 Added more ref des
    [instrumentation.sch, microcontroiller.sch, power.sch]
2022-01-18 Finished adding TMP sensors and footprints
    [instrumentation.sch, mallard.kicad_pcb, microcontroiller.sch, power.sch]
2022-01-19 Added UART connector on STM32
    [microcontroiller.sch]
2022-01-20 Added LMP7721
    Added LMP7721 in parallel to op amp A channel circuit. Added jumpers to be able to select path. Added R11 and R12, R8 changed to DNI
    [instrumentation.sch]
2022-01-23 Updated footprint and added decoupling caps
    [instrumentation.sch, mallard.csv, mallard.kicad_pcb, microcontroiller.sch]
2022-01-23 Schematic prepared for Layout
    [mallard.kicad_pcb, mallard.sch]
2022-01-23 Added screw terminals for solar panel, and added a cap
    [mallard.kicad_pcb, mallard.sch]
2022-01-24 Schematic finished, layout stared
    [mallard.kicad_pcb, mallard.sch]
2022-01-24 Modified footprints and added items to BOM
    [mallard.kicad_pcb, mallard.sch]
2022-01-25 Schematic and Layout Finished
    Needs review
    [mallard.kicad_pcb, mallard.sch]
2022-01-25 Updated footprints
    [mallard.kicad_pcb, mallard.sch]
2022-01-25 Misc kicad meta data
2022-01-25 Finished schematic and layout
    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
    [mallard.kicad_pcb, mallard.sch]
2022-01-26 Small layout changes
    [mallard.kicad_pcb]
2022-01-26 Revised layout, fixed schematic errors
    [mallard.kicad_pcb, mallard.sch]
2022-01-26 Created new STM32 firmware project with alt. MC
    [mallard Debug.cfg]
2022-01-26 Changes some components on BOM
    [mallard.csv, mallard.kicad_pcb, mallard.sch]
2022-01-26 Replaced -3V charge pump with LM828
    [mallard.kicad_pcb, mallard.sch]
2022-01-26 Updated temperature sensor PN
    [mallard.sch]
2022-01-27 Found alts for passives
    [mallard.csv, mallard.sch]
2022-01-27 Updated digikey part #
    [mallard.sch]
2022-01-31 Tidied up schematic
    [mallard-B_Cu.gbr, mallard-B_Mask.gbr, mallard-B_Paste.gbr, mallard-B_SilkS.gbr, mallard-Edge_Cuts.gbr, mallard-F_Cu.gbr, mallard-F_Mask.gbr, mallard-F_Paste.gbr]
2022-03-19 Expanded firmware to activate regulators and output UART
